The-256-Foundation/Ember-One/3d/DCK0005A.stp

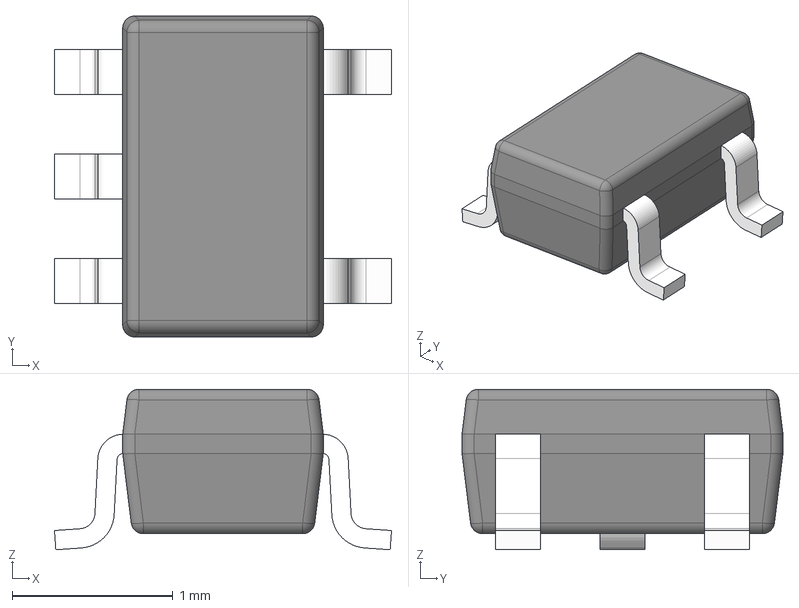
[picture p2: CAD file, 2025-03-15]
3d/DCK0005A.stp
2.10 x 2.00 x 1.00 mm
BODY-SOT
LEAD-SOT x 5
PIN1-ID
