The-256-Foundation/Ember-One/3d/MMCX-P-P-H-ST-TH1.step

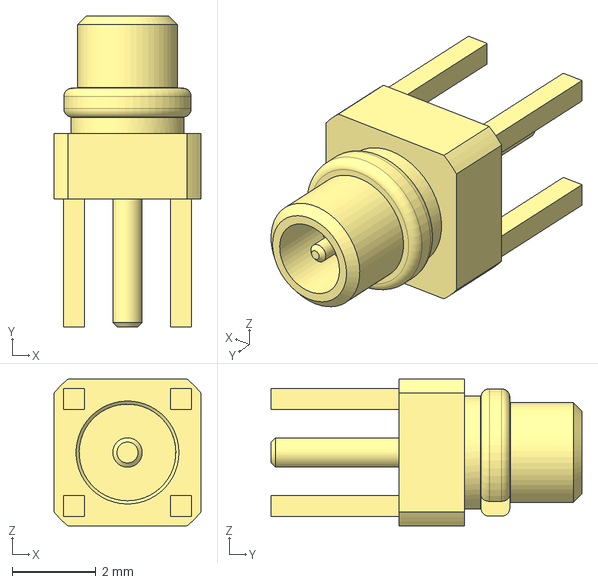
[picture p3: CAD file, 2025-03-14]
3d/MMCX-P-P-H-ST-TH1.step
3.50 x 7.40 x 3.50 mm
