The-256-Foundation/Ember-One/3d/CONSMA001-SMD-G.step

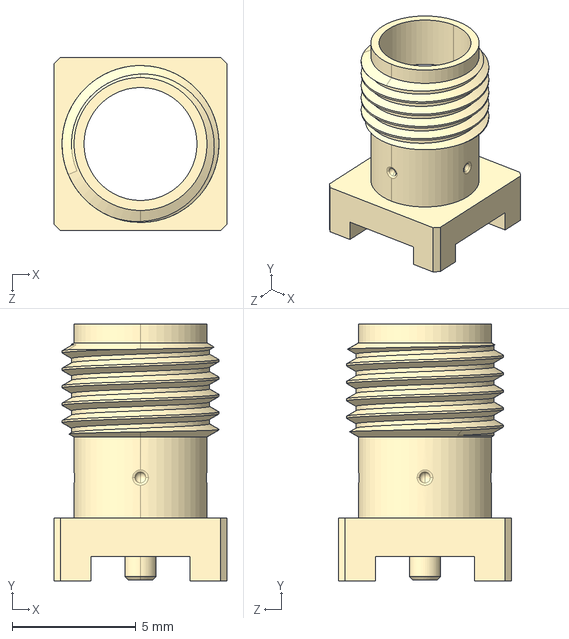
[picture p4: CAD file, 2025-03-13]
3d/CONSMA001-SMD-G.step
7.00 x 10.4 x 7.00 mm
