The-256-Foundation/Ember-One/3d/70x90_heatsink-Body.step

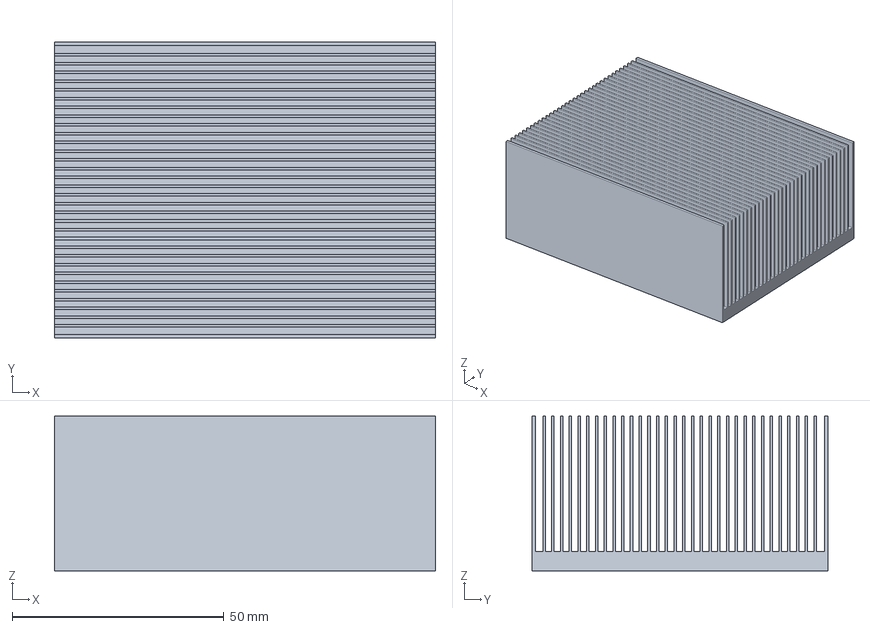
[picture p5: CAD file, 2025-01-16]
3d/70x90_heatsink-Body.step
90.0 x 70.0 x 36.6 mm
