The-256-Foundation/Ember-One/3d/BM1362.step

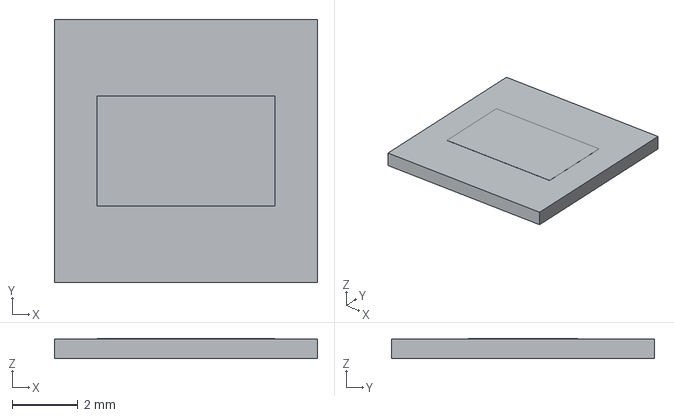
[picture p6: CAD file, 2025-01-03]
3d/BM1362.step
8.00 x 8.00 x 0.61 mm

3d/DGK0008A.stp
4.90 x 3.00 x 1.10 mm
BODY_MUA08A
LEAD_MUA08A x 8
