The-256-Foundation/Ember-One/3d/TLV1117LV33DCYR.step

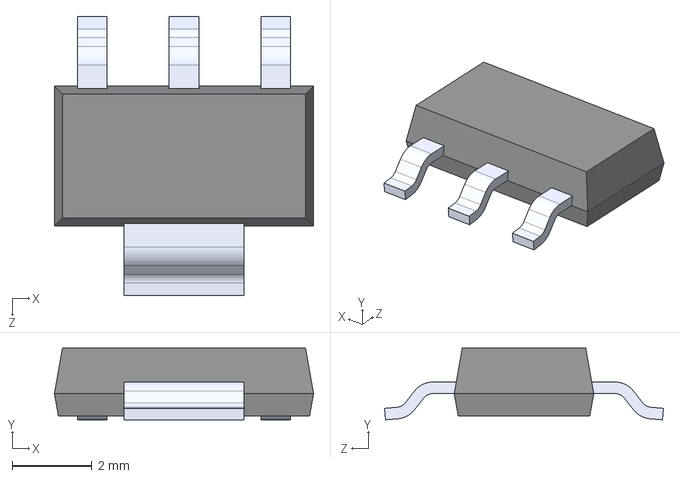
[picture p8: CAD file, 2024-12-31]
3d/TLV1117LV33DCYR.step
6.50 x 1.80 x 7.00 mm
