The-256-Foundation/Ember-One/3d/OSC_3225MV.step

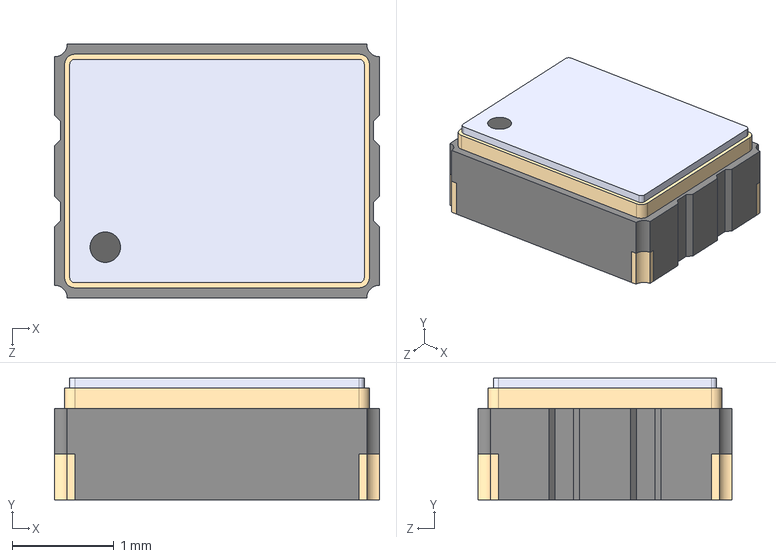
[picture p9: CAD file, 2024-12-31]
3d/OSC_3225MV.step
3.20 x 1.20 x 2.50 mm
