The-256-Foundation/Ember-One/3d/SOT_RG1_DIO.step

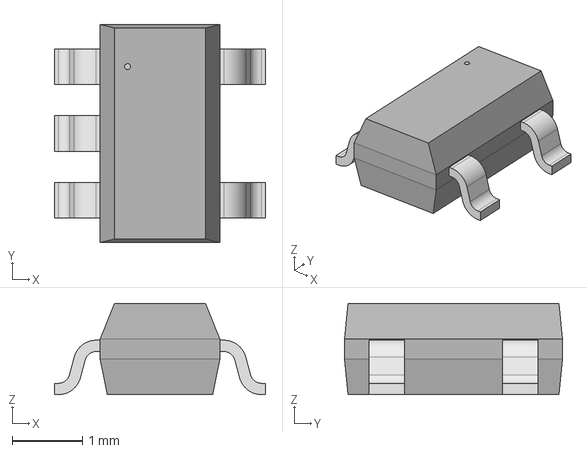
[picture p10: CAD file, 2024-12-31]
3d/SOT_RG1_DIO.step
3.00 x 3.10 x 1.30 mm
