The-256-Foundation/Ember-One/3d/USON-8_UX_2x3x0p6_WIN.step

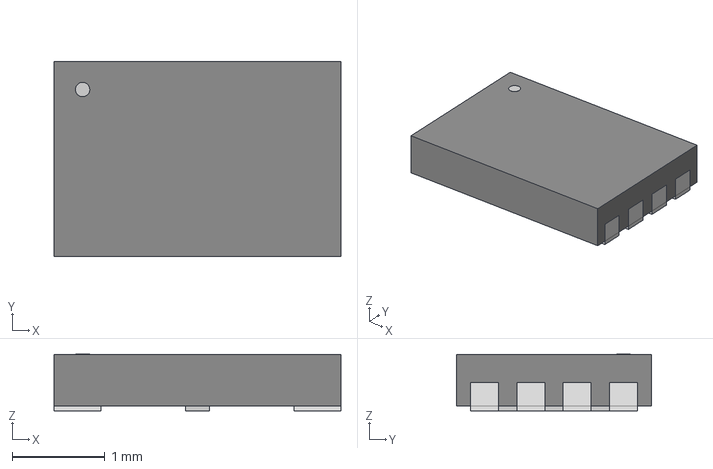
[picture p11: CAD file, 2024-12-31]
3d/USON-8_UX_2x3x0p6_WIN.step
3.10 x 2.11 x 0.612 mm
