The-256-Foundation/Ember-One/3d/Crystal_3225.step

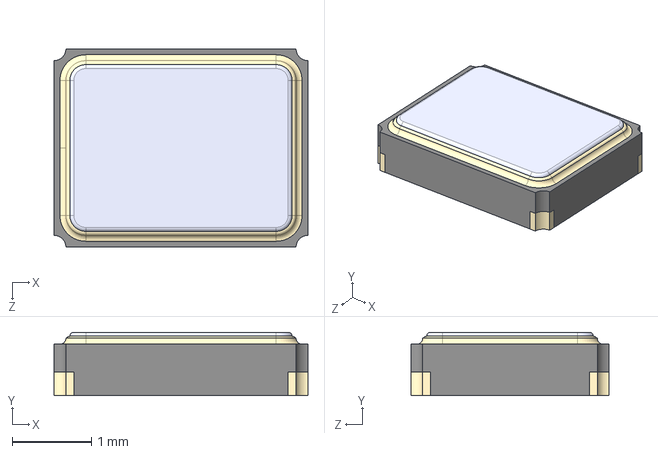
[picture p12: CAD file, 2024-12-31]
3d/Crystal_3225.step
3.20 x 0.8 x 2.50 mm
