The-256-Foundation/Ember-One/3d/SDO_4S13R-G_TOR.step

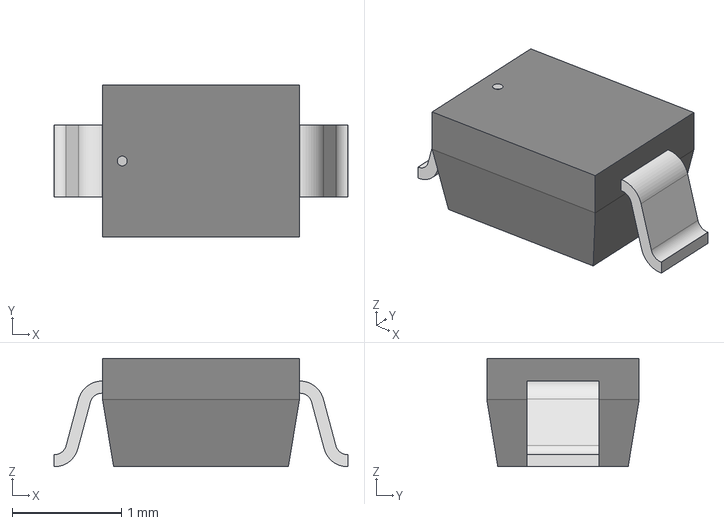
[picture p13: CAD file, 2024-10-13]
3d/SDO_4S13R-G_TOR.step
2.69 x 1.40 x 0.993 mm
