The-256-Foundation/Ember-One/3d/WSR.step

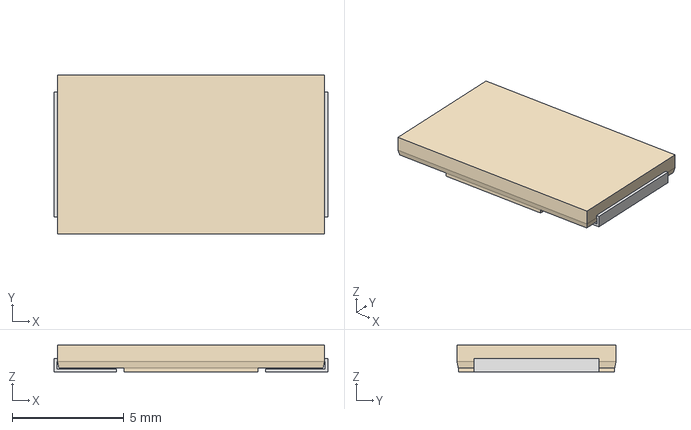
[picture p14: CAD file, 2024-10-13]
3d/WSR.step
12.2 x 7.11 x 1.19 mm
