The-256-Foundation/Ember-One/3d/8 SIZE CODE E12.stp

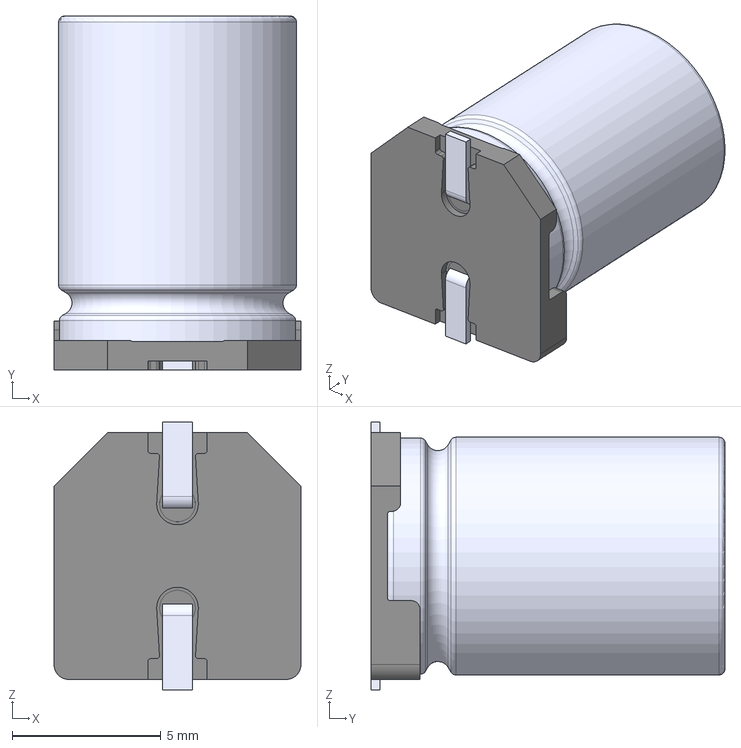
[picture p15: CAD file, 2024-10-13]
3d/8 SIZE CODE E12.stp
8.30 x 11.9 x 9.00 mm
