The-256-Foundation/Ember-One/3d/Coilcraft-SER2915H.STEP

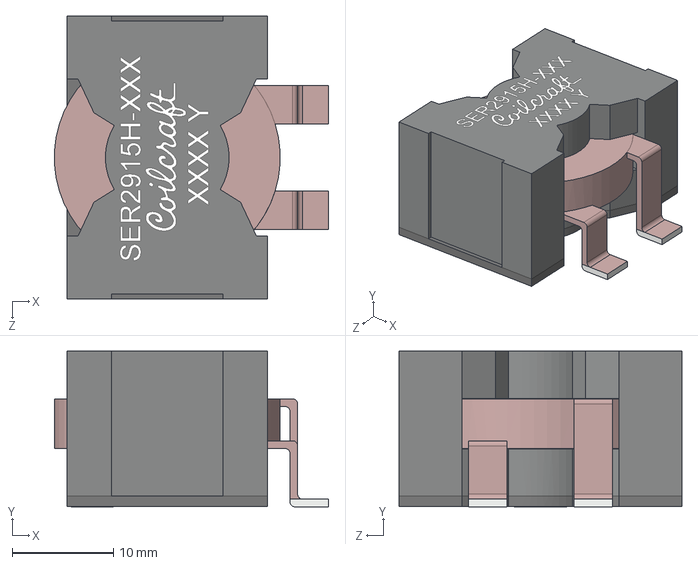
[picture p16: CAD file, 2024-10-13]
3d/Coilcraft-SER2915H.STEP
27.0 x 15.4 x 27.9 mm
