The-256-Foundation/Ember-One/3d/CHEMI-H80.step

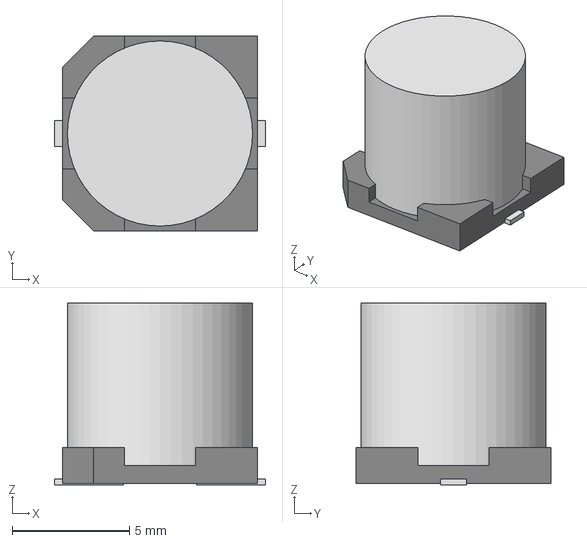
[picture p17: CAD file, 2024-10-13]
3d/CHEMI-H80.step
8.99 x 8.31 x 7.75 mm
