The-256-Foundation/Ember-One/3d/DQJ0008A.stp

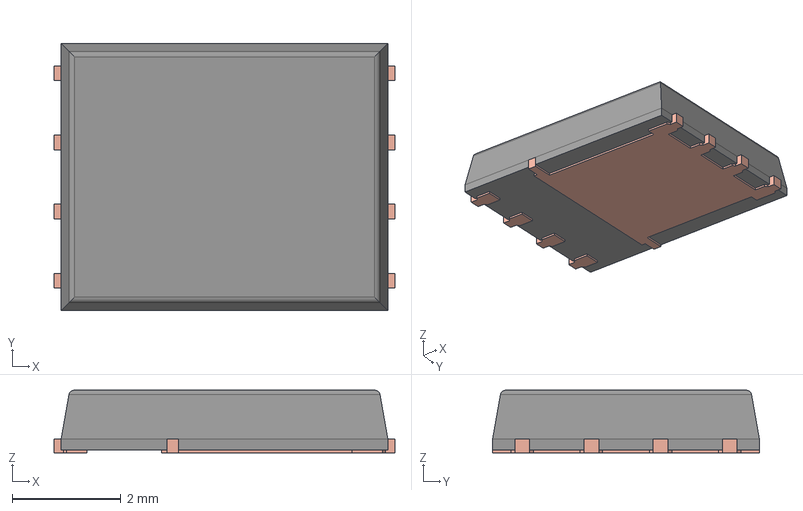
[picture p18: CAD file, 2024-10-13]
3d/DQJ0008A.stp
6.26 x 4.90 x 1.15 mm
FRAME
MOLD
