The-256-Foundation/Ember-One/3d/RTV0032A.stp

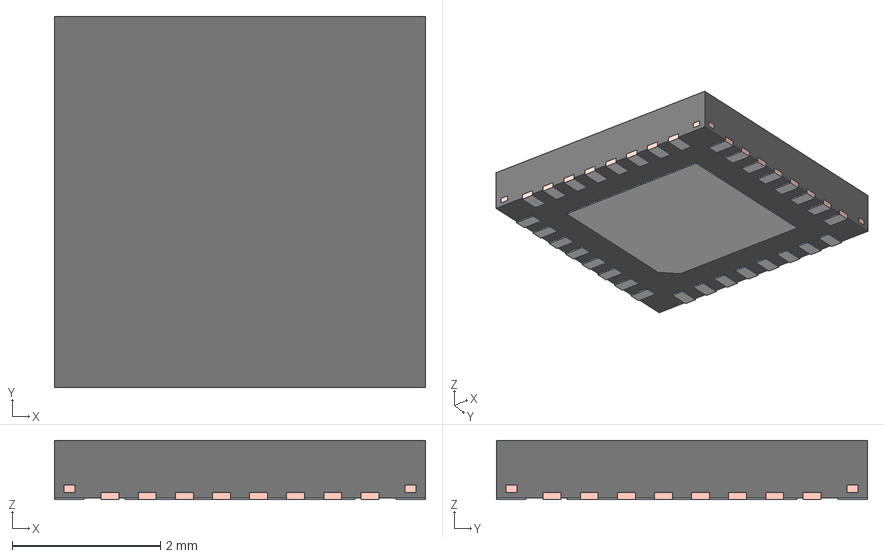
[picture p19: CAD file, 2024-10-12]
3d/RTV0032A.stp
5.00 x 5.00 x 0.8 mm
FRAME
PIN1_AREA
