The-256-Foundation/Ember-One/3d/RTA0040B.stp

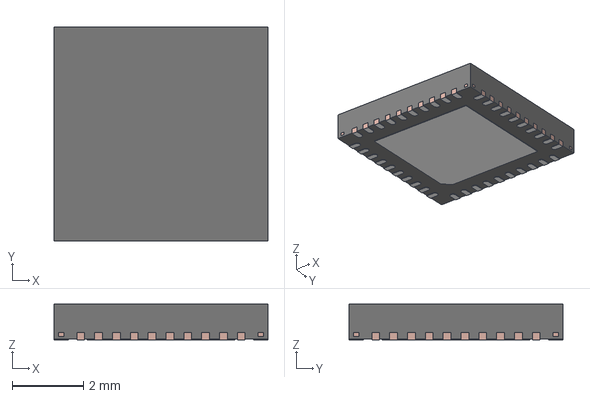
[picture p20: CAD file, 2024-10-12]
3d/RTA0040B.stp
6.00 x 6.00 x 1.00 mm
FRAME
