The-256-Foundation/Ember-One/3d/DQP0012A.stp

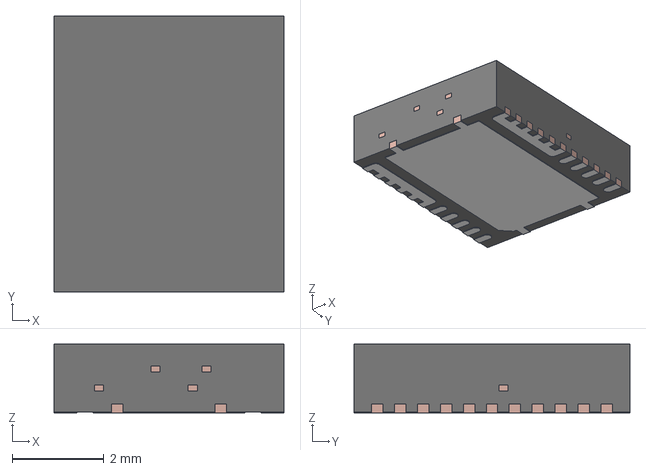
[picture p21: CAD file, 2024-10-12]
3d/DQP0012A.stp
5.00 x 6.00 x 1.50 mm
FRAME
MOLD
