The-256-Foundation/Ember-One/(list of files, cad)

Other CAD files:
3d/7770-ScrewTerminal.step
