The-256-Foundation/Ember-One/(commit log)

2024-10-12 initital import
    [asics.kicad_sch, emberone.kicad_pcb, emberone.kicad_sch, power.kicad_sch]
2024-10-12 added main regulator parts
    [DQP0012A.stp, RTA0040B.stp, asics.kicad_sch, emberone.kicad_sch, power.kicad_sch]
2024-10-12 pausing on the TPS53647 and trying the LM25119 for higher input voltage
    [power.kicad_sch]
2024-10-12 started adding LM25119
    [RTV0032A.stp, power.kicad_sch]
2024-10-12 the voltage regulator schematic is in
    [power.kicad_sch]
2024-10-13 added all the power footprints, DS4432U and INA260 schematic
    [8 SIZE CODE E12.stp, CHEMI-H80.step, Coilcraft-SER2915H.STEP, DQJ0008A.stp, SDO_4S13R-G_TOR.step, WSR.step, asics.kicad_sch, emberone.kicad_sch]
2024-10-17 schematic done, started initial placement
    [7770-ScrewTerminal.step, asics.kicad_sch, emberone.kicad_pcb, emberone.kicad_sch, power.kicad_sch]
2024-10-21 finished routing. passes DRC
    [emberone.kicad_pcb, power.kicad_sch]
2024-10-21 added schematic partnumbers
    [emberone.kicad_pcb, power.kicad_sch]
2024-10-21 added gerbers and BOM
    [emberone BOM.csv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]
2024-10-28 add iBOM
    [emberone BOM.csv, emberone.kicad_sch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]
2024-11-19 added BM1362AC symbol and footprint
    [asics.kicad_sch, emberone.kicad_pcb]
2024-11-25 adding initial ASIC stacks
    [asic-3up-1.kicad_sch, asic-3up-2.kicad_sch, asic-3up-3.kicad_sch, asic-3up-4.kicad_sch, asics.kicad_sch, emberone.kicad_sch]
2024-11-26 added all the ASICs to the schematic. added the RP2040 circuit for data. added the VDDIO boost circuit. schematic cleanup
    [asic-3up-0.kicad_sch, asic-3up-2.kicad_sch, asic-3up-3.kicad_sch, asic-3up-4.kicad_sch, asics.kicad_sch, data.kicad_sch, emberone.kicad_sch, power.kicad_sch]
2024-11-26 added sweet logo to schematic worksheet. Schematic cleanup.
    [asic-3up-0.kicad_sch, asic-3up-1.kicad_sch, asic-3up-2.kicad_sch, asic-3up-3.kicad_sch, asics.kicad_sch, data.kicad_sch, emberone.kicad_sch]
2024-11-26 remove old, out of date manufacturing files
    [emberone BOM.csv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]
2024-12-16 starting layout
    [asic-3up-0.kicad_sch, asic-3up-1.kicad_sch, asic-3up-2.kicad_sch, asic-3up-3.kicad_sch, emberone.kicad_pcb, power.kicad_sch]
2024-12-19 so much placing. added mask and paste opening on ASIC footprints. added a pad for a rear heatsink
    [asic-3up-0.kicad_sch, asic-3up-1.kicad_sch, asic-3up-2.kicad_sch, asic-3up-3.kicad_sch, emberone.kicad_pcb]
2024-12-19 forgot that data needs to start with the ASIC that has GND at system GND... reversed everything
    [asic-3up-0.kicad_sch, asic-3up-1.kicad_sch, asic-3up-2.kicad_sch, asic-3up-3.kicad_sch, emberone.kicad_pcb, emberone.kicad_sch]
2024-12-19 added the heatsink mounting holes
    [asic-3up-1.kicad_sch, asic-3up-2.kicad_sch, asic-3up-3.kicad_sch, emberone.kicad_pcb, emberone.kicad_sch]
2024-12-19 square up mounting holes
    [emberone.kicad_pcb]
2024-12-19 placements done. shrunk test points
    [asic-3up-0.kicad_sch, asic-3up-1.kicad_sch, asic-3up-2.kicad_sch, asic-3up-3.kicad_sch, data.kicad_sch, emberone.kicad_pcb]
2024-12-19 more routing
    [emberone.kicad_pcb]
2024-12-28 moved all the clearance issue passives to the back side and mostly re-routed
    [emberone.kicad_pcb, power.kicad_sch]
2024-12-28 Switched to 5V for VDDIO LDO input.. cleaned up RP2040 circuit. Need to place and route testpoints
    [data.kicad_sch, emberone.kicad_pcb, emberone.kicad_sch]
2024-12-29 added temp sensors. wired up (hopeful) vreg EN circuit. lots of LDO routing.
    [asic-3up-0.kicad_sch, asic-3up-1.kicad_sch, asic-3up-2.kicad_sch, asic-3up-3.kicad_sch, data.kicad_sch, emberone.kicad_pcb, emberone.kicad_sch, power.kicad_sch]
2024-12-30 all placed *almost* all routed
    [asic-3up-0.kicad_sch, asic-3up-1.kicad_sch, asic-3up-2.kicad_sch, asic-3up-3.kicad_sch, data.kicad_sch, emberone.kicad_pcb, emberone.kicad_sch]
2024-12-30 routing done!
    [emberone.kicad_pcb]
2024-12-30 cleaned up DRC
    [asic-3up-0.kicad_sch, asic-3up-3.kicad_sch, emberone.kicad_pcb]
2024-12-30 DRC clean
    [emberone.kicad_pcb]
2024-12-31 changed the RP2040 Flash to a QSPI version. Added DK RP2040 crystal. Added LED. Added some 3D models. Generated BOM. Generated Gerbers
    [Crystal_3225.step, OSC_3225MV.step, SOT_RG1_DIO.step, USON-8_UX_2x3x0p6_WIN.step, asic-3up-0.kicad_sch, asic-3up-1.kicad_sch, asic-3up-2.kicad_sch, asic-3up-3.kicad_sch]
2024-12-31 switched to beefier 3.3V LDO
    [TLV1117LV33DCYR.step, data.kicad_sch, emberone.kicad_pcb]
2024-12-31 final cleanup. checked BOM, gerbers. Added 256F Logo
    [DGK0008A.stp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]
2024-12-31 added 4mm margin edge cut all around PCB
    [emberone-B_Cu.gbr, emberone-B_Mask.gbr, emberone-B_Paste.gbr, emberone-B_Silkscreen.gbr, emberone-Edge_Cuts.gbr, emberone-F_Cu.gbr, emberone-F_Mask.gbr, emberone-F_Paste.gbr]
2025-01-03 add BM1362 3d model
    [BM1362.step, emberone.kicad_pcb]
2025-01-03 update PCB render
2025-01-14 switching to 6.5mil trace/space for 2oz copper.. not finished yet
    [emberone-B_Cu.gbr, emberone-B_Mask.gbr, emberone-B_Paste.gbr, emberone-B_Silkscreen.gbr, emberone-Edge_Cuts.gbr, emberone-F_Cu.gbr, emberone-F_Mask.gbr, emberone-F_Paste.gbr]
2025-01-14 all 2oz trace/space DRC errors fixed
    [emberone.kicad_pcb]
2025-01-14 DRC warnings cleanup. recentered logo
    [emberone.kicad_pcb, emberone.kicad_sch]
2025-01-15 generated updated gerbers
    [asic-3up-0.kicad_sch, asic-3up-1.kicad_sch, asic-3up-2.kicad_sch, asic-3up-3.kicad_sch, data.kicad_sch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]
2025-01-16 added 70x90 heatsink model
    [70x90_heatsink-Body.step, emberone.kicad_pcb, emberone.kicad_sch]
2025-01-23 updated the partno for C6,C10 for #3 regenerated BOM
    [emberone BOM.csv, power.kicad_sch]
2025-02-05 add iBOM for hand assembly
2025-02-20 update project to KiCad v9
    [asic-3up-0.kicad_sch, asic-3up-1.kicad_sch, asic-3up-2.kicad_sch, asic-3up-3.kicad_sch, data.kicad_sch, emberone.kicad_pcb, emberone.kicad_sch, power.kicad_sch]
2025-02-25 fix PIN_MODE connections for #17
    [asic-3up-0.kicad_sch, asic-3up-2.kicad_sch, emberone.kicad_pcb]
2025-02-25 added RI pullup resistors for #16. updated BOM. bumped version number to 3
    [asic-3up-0.kicad_sch, asic-3up-1.kicad_sch, asic-3up-2.kicad_sch, asic-3up-3.kicad_sch, data.kicad_sch, emberone BOM.csv, emberone.kicad_pcb, emberone.kicad_sch]
2025-03-05 added fix for #22. deleted old gerbers
    [asic-3up-0.kicad_sch, asic-3up-1.kicad_sch, asic-3up-2.kicad_sch, asic-3up-3.kicad_sch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]
2025-03-11 added ceramic output caps for #26, added SW Node snubbers for #25, added LO and HO resistor pads for #24, reoriented inductors for #23. Changed R_FS/R11 to 39k for #21, updated BM1362 footprint spaci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
    [emberone.kicad_pcb, power.kicad_sch]
2025-03-12 tightened up the SW loops a bit in layout
    [emberone.kicad_pcb, power.kicad_sch]
2025-03-12 more loop tightening
    [emberone.kicad_pcb]
2025-03-13 added SMA VDD test port. Switched to 6 layers and doubled up power tracks.
    [CONSMA001-SMD-G.step, emberone.kicad_pcb, power.kicad_sch]
2025-03-14 track and silkscreen cleanup
    [emberone.kicad_pcb]
2025-03-14 switched big SMA for a smaller MMCX connector
    [MMCX-P-P-H-ST-TH1.step, emberone.kicad_pcb, power.kicad_sch]
2025-03-14 updated BM1362 footprints to 0.64mm pitch for #18. adjusted tracks, DRC
    [emberone.kicad_pcb]
2025-03-14 added GND guard on FB
    [emberone.kicad_pcb]
2025-03-14 added LM25119-datasheet recommended filter on CSx/CSGx pins
    [emberone.kicad_pcb, power.kicad_sch]
2025-03-14 added series resistors on data pins between level shifter and 1st ASIC. added pullup on RO
    [asic-3up-3.kicad_sch, emberone.kicad_pcb]
2025-03-15 added a level shifter for the LFG-LED
    [DCK0005A.stp, data.kicad_sch, emberone.kicad_pcb]
2025-03-16 removed the LED level shifter (it works fine without)
    [data.kicad_sch, emberone.kicad_pcb]
2025-03-16 reduced center pad paste amount. cleaned up ASIC footprint vias. moved vreg passives around to better fit model name
    [asic-3up-0.kicad_sch, asic-3up-3.kicad_sch, data.kicad_sch, emberone.kicad_pcb, power.kicad_sch]
2025-03-16 removed the really big openings in the stencil. fixed up a wonky LM25119 paste layer. generated gerbers and BOM
    [emberone BOM.csv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]
2025-04-30 DNP low side FET snubber circuit for now (to be redone in v4). Update current sense resistor filter values. regenerate BOM, iBOM. Slight slikscreen cleanup. regenerated gerbers
    [asic-3up-0.kicad_sch, asic-3up-1.kicad_sch, asic-3up-2.kicad_sch, asic-3up-3.kicad_sch, emberone BOM.csv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]
2025-04-30 add assembly tips doc.
2025-05-18 Added Mfg to BOM
    [asic-3up-0.kicad_sch, asic-3up-1.kicad_sch, asic-3up-2.kicad_sch, asic-3up-3.kicad_sch, data.kicad_sch, emberone BOM.csv, emberone.kicad_sch, power.kicad_sch]
2025-05-18 missed a few
    [asic-3up-0.kicad_sch, asic-3up-1.kicad_sch, asic-3up-2.kicad_sch, asic-3up-3.kicad_sch, data.kicad_sch, emberone BOM.csv]
2025-05-18 fixed wrong part number
    [asic-3up-0.kicad_sch, asic-3up-3.kicad_sch, emberone BOM.csv]
