The-256-Foundation/Ember-One/(notices)

Notices in the files:
3d/MMCX-P-P-H-ST-TH1.step:
author */ ('License CC BY-ND 4.0'),
